Vineshelby/viveiro/viveiroPCB/viveiroPCB.kicad_pcb

## KiCad design viveiroPCB/viveiroPCB.kicad_pcb (2025-01-22)

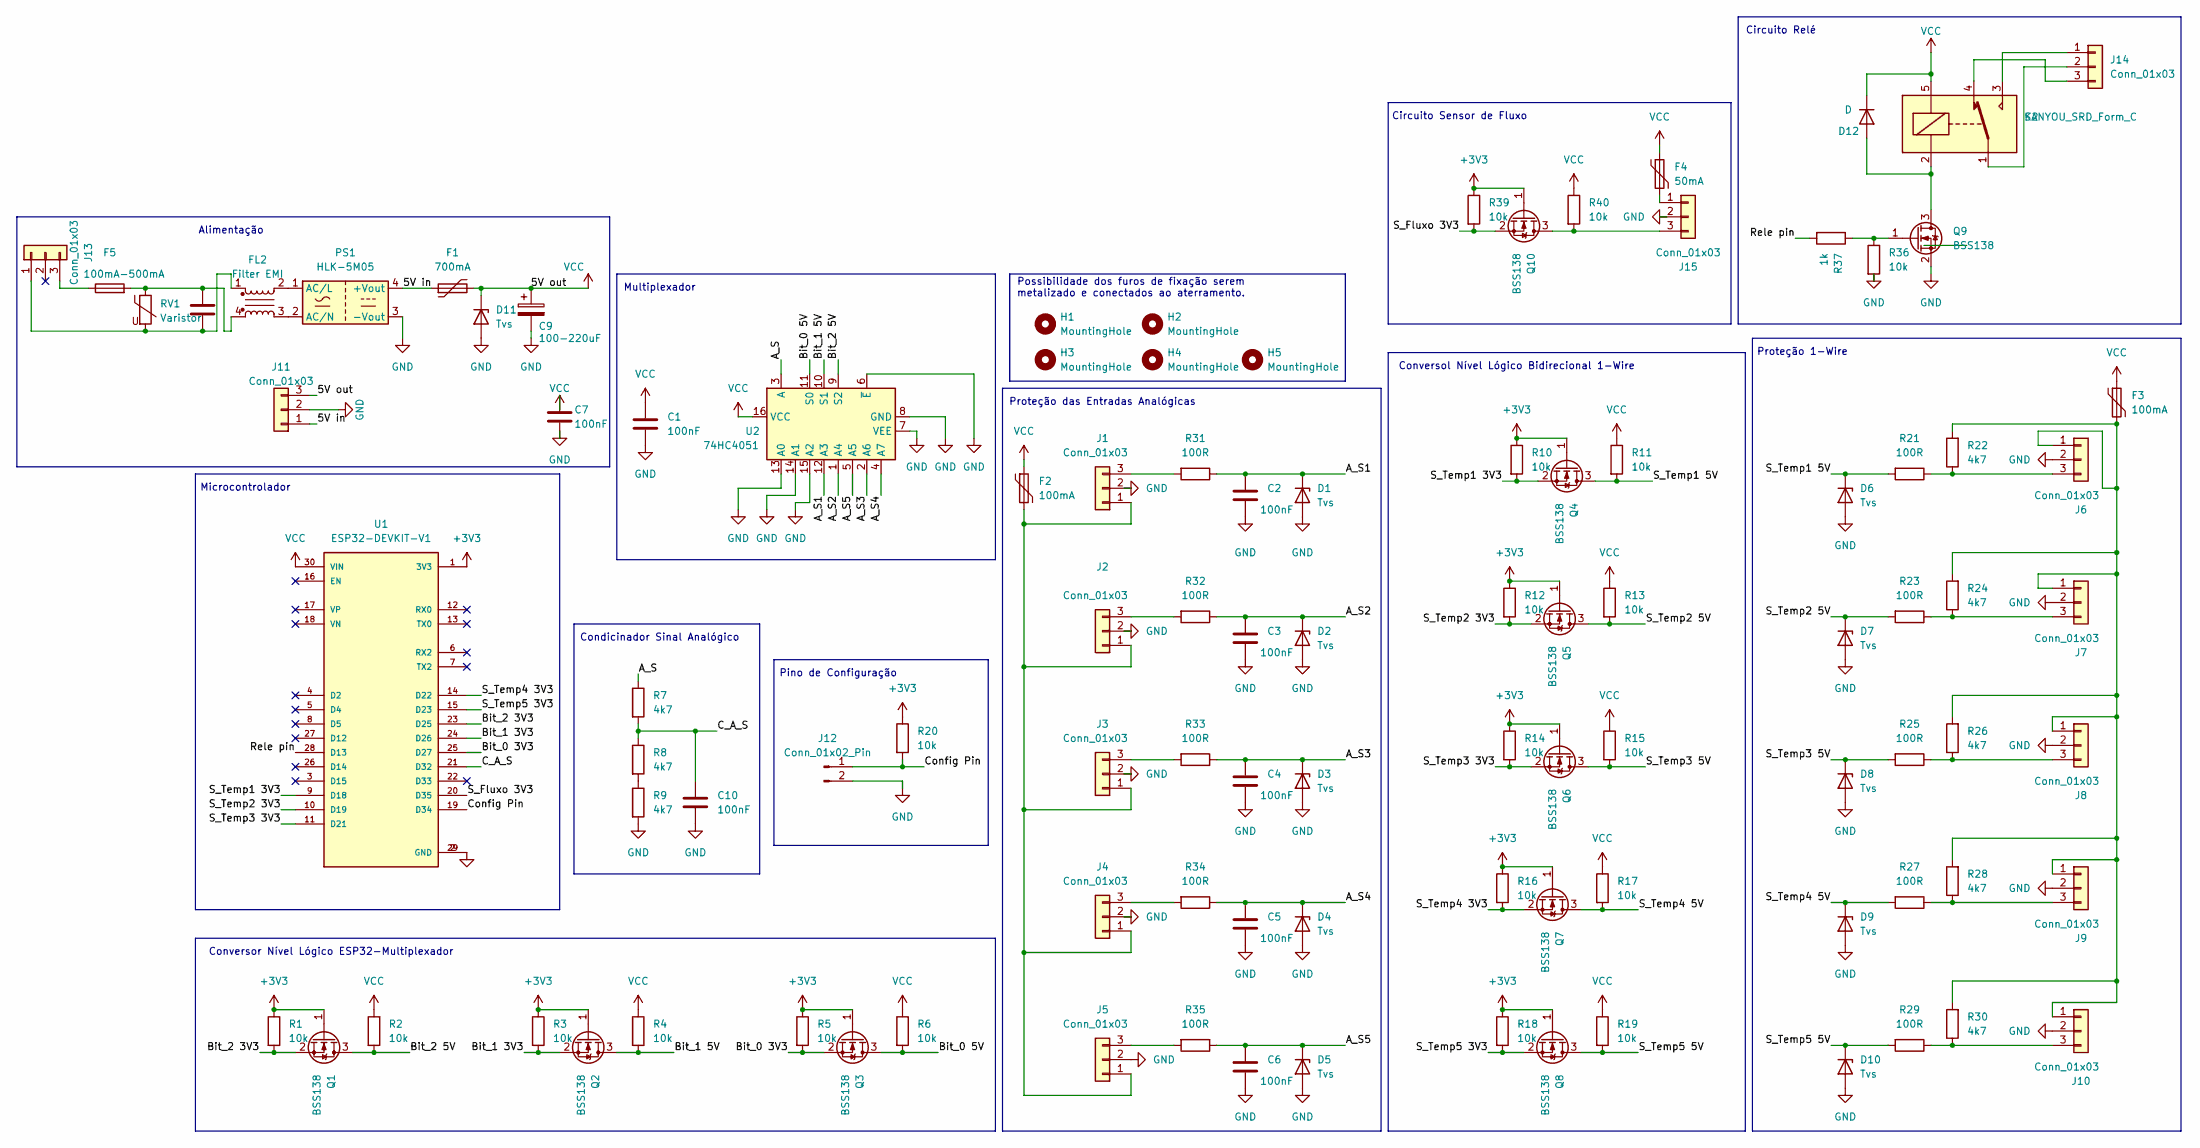
[picture p1: schematic viveiroPCB.kicad_sch, Viveiro]

Parts:
C1, C2, C3, C4, C5, C6, C7, C10: 100nF; C_0805_2012Metric
C8: 0.1uF; C_Rect_L13.5mm_W5.0mm_P10.00mm_FKS3_FKP3_MKS4
C9: 100-220uF; CP_Radial_D10.0mm_P3.80mm
D1, D2, D3, D4, D5, D6, D7, D8, D9, D10, D11: Tvs; D_SMB
D12: D; D_SMA
F1: 700mA; Fuse_1206_3216Metric
F2, F3: 100mA; Fuse_1206_3216Metric
F4: 50mA; Fuse_1206_3216Metric
F5: 100mA-500mA; Fuseholder_Cylinder-5x20mm_Schurter_0031_8201_Horizontal_Op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
FL2: Filter EMI; uu9.8
H1, H2, H3, H4, H5: MountingHole; MountingHole_3.2mm_M3_DIN965
J1, J2, J3, J4, J5, J6, J7, J8, J9, J10, J15: Conn_01x03; Molex_KK-254_AE-6410-03A_1x03_P2.54mm_Vertical
J11, J13, J14: Conn_01x03; PhoenixContact_MSTBA_2,5_3-G-5,08_1x03_P5.08mm_Horizontal
J12: Conn_01x02_Pin; PinHeader_1x02_P2.54mm_Vertical
K2: SANYOU_SRD_Form_C; Relay_SPDT_SANYOU_SRD_Series_Form_C
PS1: HLK-5M05; Converter_ACDC_Hi-Link_HLK-5Mxx
Q1, Q2, Q3, Q4, Q5, Q6, Q7, Q8, Q9, Q10: BSS138; SOT-23
R1, R2, R3, R4, R5, R6, R10, R11, R12, R13, R14, R15, R16, R17, R18, R19, R20, R36, R39, R40: 10k; R_0805_2012Metric
R7, R8, R9, R22, R24, R26, R28, R30: 4k7; R_0805_2012Metric
R21, R23, R25, R27, R29, R31, R32, R33, R34, R35: 100R; R_1206_3216Metric
R37: 1k; R_0805_2012Metric
RV1: Varistor; RV_Disc_D12mm_W7.1mm_P7.5mm
U1: ESP32-DEVKIT-V1; MODULE_ESP32_DEVKIT_V1; PARTREV N/A
U2: 74HC4051; SO-16_3.9x9.9mm_P1.27mm

Connections:
+3V3: Q1.1 (G), Q2.1 (G), Q3.1 (G), Q4.1 (G), Q5.1 (G), Q6.1 (G), Q7.1 (G), Q8.1 (G), Q10.1 (G), R1.1, R3.1, R5.1, R10.1, R12.1, R14.1, R16.1, R18.1, R20.1, R39.1, U1.1 (3V3)
/5V in: F1.1, J11.1, PS1.4 (+Vout)
/A_S: R7.1, U2.3 (A)
/A_S1: C2.1, D1.1 (K), R31.1, U2.12 (A3)
/A_S2: C3.1, D2.1 (K), R32.1, U2.1 (A4)
/A_S3: C4.1, D3.1 (K), R33.1, U2.2 (A6)
/A_S4: C5.1, D4.1 (K), R34.1, U2.4 (A7)
/A_S5: C6.1, D5.1 (K), R35.1, U2.5 (A5)
/Bit_0 3V3: Q3.2 (S), R5.2, U1.25 (D27)
/Bit_0 5V: Q3.3 (D), R6.2, U2.11 (S0)
/Bit_1 3V3: Q2.2 (S), R3.2, U1.24 (D26)
/Bit_1 5V: Q2.3 (D), R4.2, U2.10 (S1)
/Bit_2 3V3: Q1.2 (S), R1.2, U1.23 (D25)
/Bit_2 5V: Q1.3 (D), R2.2, U2.9 (S2)
/C_A_S: C10.1, R7.2, R8.1, U1.21 (D32)
/Config Pin: J12.1, R20.2, U1.19 (D34)
/Rele pin: R37.2, U1.28 (D13)
/S_Fluxo 3V3: Q10.2 (S), R39.2, U1.20 (D35)
/S_Temp1 3V3: Q4.2 (S), R10.2, U1.9 (D18)
/S_Temp1 5V: D6.1 (K), Q4.3 (D), R11.2, R21.2
/S_Temp2 3V3: Q5.2 (S), R12.2, U1.10 (D19)
/S_Temp2 5V: D7.1 (K), Q5.3 (D), R13.2, R23.2
/S_Temp3 3V3: Q6.2 (S), R14.2, U1.11 (D21)
/S_Temp3 5V: D8.1 (K), Q6.3 (D), R15.2, R25.2
/S_Temp4 3V3: Q7.2 (S), R16.2, U1.14 (D22)
/S_Temp4 5V: D9.1 (K), Q7.3 (D), R17.2, R27.2
/S_Temp5 3V3: Q8.2 (S), R18.2, U1.15 (D23)
/S_Temp5 5V: D10.1 (K), Q8.3 (D), R19.2, R29.2
GND: C1.2, C2.2, C3.2, C4.2, C5.2, C6.2, C7.2, C9.2, C10.2, D1.2 (A), D2.2 (A), D3.2 (A), D4.2 (A), D5.2 (A), D6.2 (A), D7.2 (A), D8.2 (A), D9.2 (A), D10.2 (A), D11.2 (A), J1.2, J2.2, J3.2, J4.2, J5.2, J6.2, J7.2, J8.2, J9.2, J10.2, J11.2, J12.2, J15.2, PS1.3 (-Vout), Q9.2 (S), R9.2, R36.2, U1.2 (GND), U1.29 (GND), U2.6 (~E), U2.7 (VEE), U2.8 (GND), U2.13 (A0), U2.14 (A1), U2.15 (A2)
unnamed: C8.1, F5.2, FL2.4, RV1.1
unnamed: D12.2 (A), K2.2, Q9.3 (D)
unnamed: F2.2, J1.1, J2.1, J3.1, J4.1, J5.1
unnamed: J1.3, R31.2
unnamed: J2.3, R32.2
unnamed: J3.3, R33.2
unnamed: J4.3, R34.2
unnamed: J5.3, R35.2
unnamed: J6.3, R21.1, R22.1
unnamed: J7.3, R23.1, R24.1
unnamed: J8.3, R25.1, R26.1
unnamed: J9.3, R27.1, R28.1
unnamed: F3.2, J6.1, J7.1, J8.1, J9.1, J10.1, R22.2, R24.2, R26.2, R28.2, R30.2
unnamed: J10.3, R29.1, R30.1
unnamed: C8.2, FL2.1, J13.1, RV1.2
unnamed: F5.1, J13.3
unnamed: J14.1, K2.3
unnamed: J14.2, K2.1
unnamed: J14.3, K2.4
unnamed: F4.2, J15.1
unnamed: J15.3, Q10.3 (D), R40.2
unnamed: FL2.2, PS1.1 (AC/L)
unnamed: FL2.3, PS1.2 (AC/N)
unnamed: Q9.1 (G), R36.1, R37.1
unnamed: R8.2, R9.1
VCC: C1.1, C7.1, C9.1, D11.1 (K), D12.1 (K), F1.2, F2.1, F3.1, F4.1, J11.3, K2.5, R2.1, R4.1, R6.1, R11.1, R13.1, R15.1, R17.1, R19.1, R40.1, U1.30 (VIN), U2.16 (VCC)

Notes on the sheet:
Microcontrolador
Proteção das Entradas Analógicas
Multiplexador
Proteção 1-Wire
Circuito Relé
Alimentação
Possibilidade dos furos de fixação serem metalizado e conectados ao aterramento.
Circuito Sensor de Fluxo
Conversol Nível Lógico Bidirecional 1-Wire
Conversor Nível Lógico ESP32-Multiplexador
Pino de Configuração
Condicinador Sinal Analógico

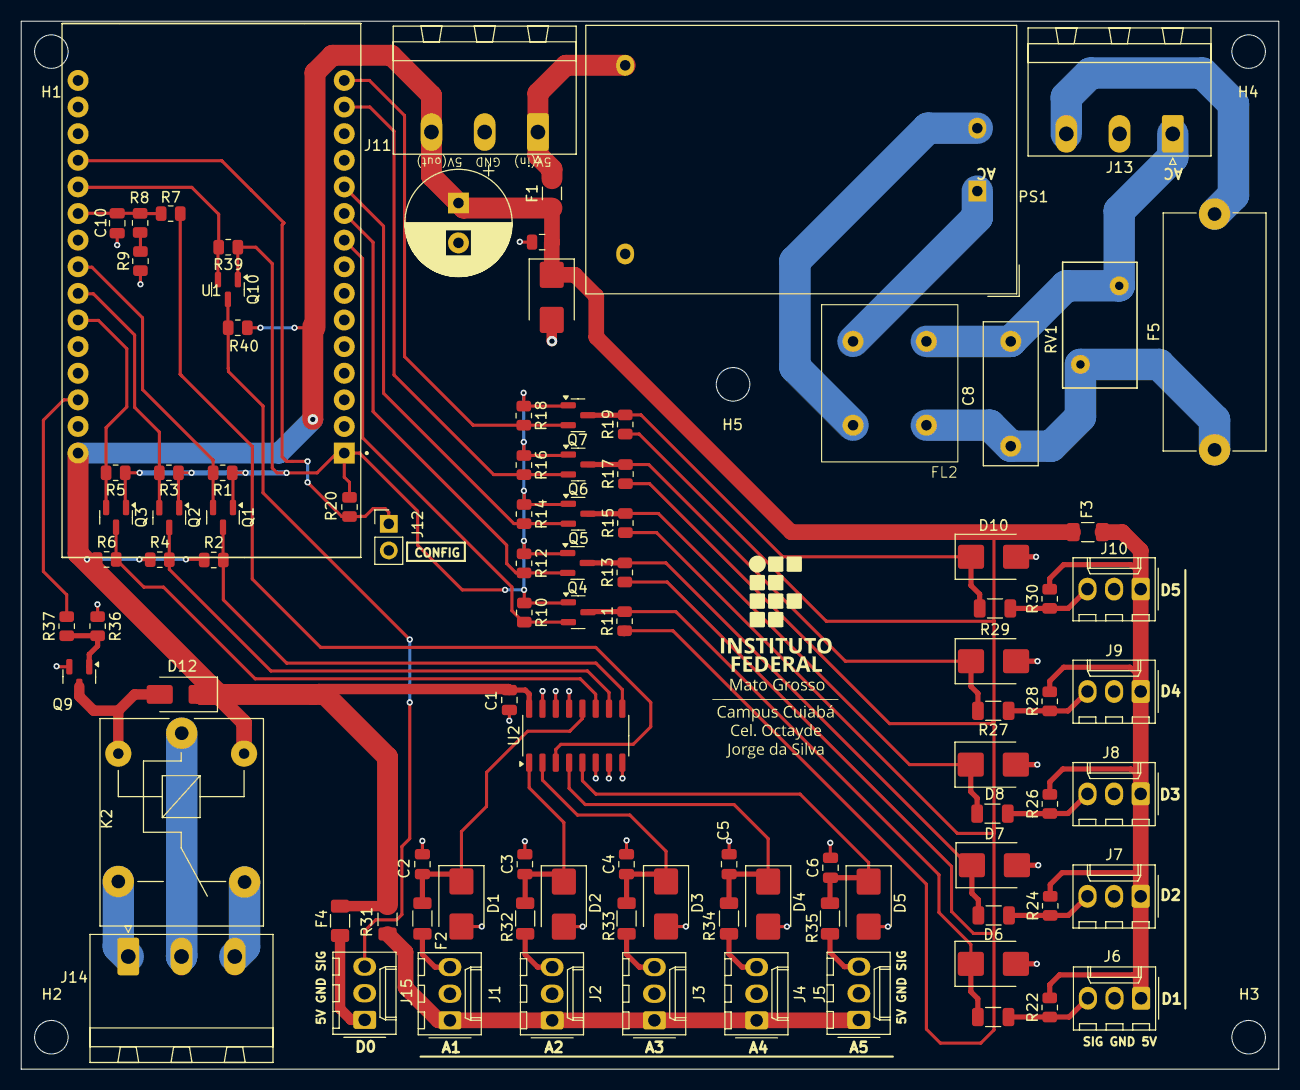
[picture p2: board viveiroPCB.kicad_pcb from above]

Board: 2 copper layers, 120.0 x 100.0 mm, 102 parts (0 on the bottom side), 55 nets.
